yorkmodular/MDM2/mdm2-lettered.dxf

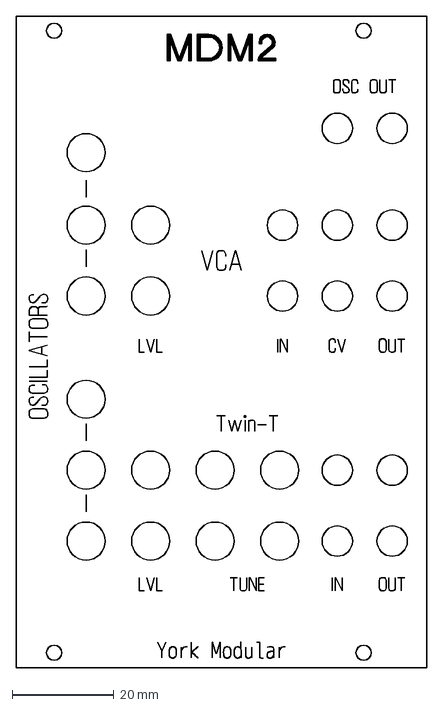
[picture p1: CAD file, 2019-05-01]
mdm2-lettered.dxf
80.9 x 128.4 mm
